Karpuls/E0001-fader-driver-board/docs/review_revC_r1/E0001_revC_bottom.png

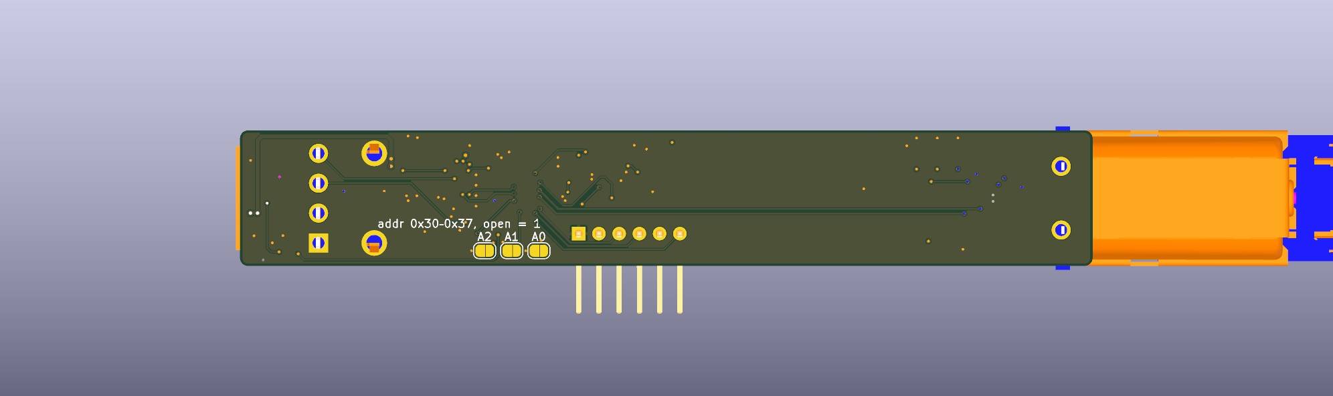
docs/review_revC_r1/E0001_revC_bottom.png
