Karpuls/E0001-fader-driver-board/fab/E0001_revC/PREORDER.md

# E0001 rev C pre-order list (Parts, 2026-10-20)
Items that are low in stock, on a long lead, or not from DigiKey. Quantities are per board.

| Item | Qty/board | Source | Stock / lead | Action |
|---|---|---|---|---|
| CL05A105KP5NNNC (1uF) | 1 | DigiKey 1276-1076-1-ND | 740739 / 61 w | order early (long lead) |
| PESD5V0L1UL,315 (PESD5V0L1UL) | 3 | DigiKey 1727-4193-1-ND | 18740 / 30 w | order early (long lead) |
| BAT54W,135 (BAT54W) | 2 | DigiKey 1727-1869-1-ND | 26776 / 30 w | order early (long lead) |
| SM04B-GHS-TB(LF)(SN) (SM04B-GHS-TB) | 1 | LCSC LCSC C189895 (SM04B-GHS-TB(LF)(SN)) | 1900 (LCSC, 2026-10-19) / 16 w | owner has JST-GH (stock flag); buy only if short |
| STM32C051F6P6 (STM32C051F6P6) | 1 | DigiKey 497-STM32C051F6P6-ND | 47 / 52 w | buy first |

## Notes
- **U1 STM32C051F6P6:** 47 in stock at DigiKey; the approved alternate **STM32C051F8P6** (497-STM32C051F8P6-ND, same pinout, 64 KB) has more stock. Buy whichever is in stock.
- **J1 SM04B-GHS-TB:** owner has JST-GH connectors (flag only; the BOM keeps the line). If more are needed: DigiKey 0 stock; LCSC C189895 (min order 5) or RS Online 1755704 / 7521797.

- **RV1 fader:** owner has the faders (Owner stock = yes); the Amazon.de line (ASIN B0H45B29YK) stays in the BOM at full quantity.
