Karpuls/E0001-fader-driver-board/fab/E0001_revC/reports/E0001_revC_gerber_render.png

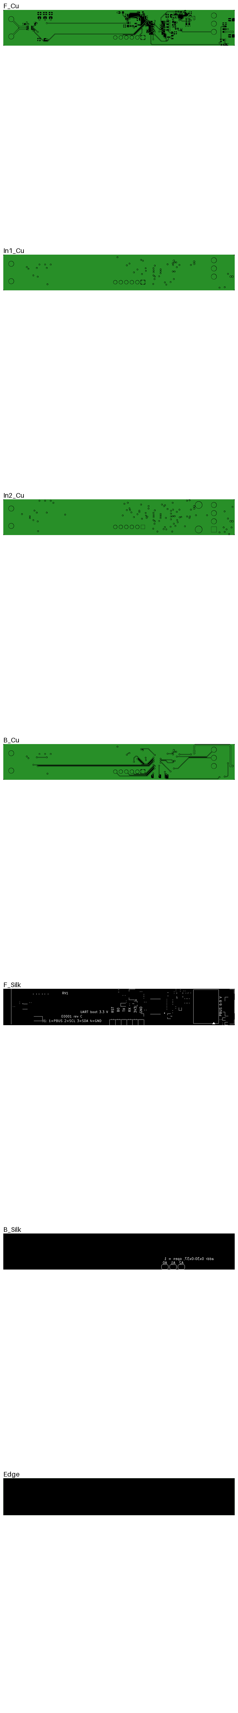
fab/E0001_revC/reports/E0001_revC_gerber_render.png
