Karpuls/E0001-fader-driver-board/bom/E0001_revB_digikey_bom.csv

Quantity | Manufacturer Part Number | Manufacturer | DigiKey Part Number | Value | Package | Designators | Description
1 | CL21A106KPCLQNC | Samsung | 1276-2402-1-ND | 10uF | C_0805_2012Metric | C1 | Unpolarized capacitor, small symbol
2 | GRM188R61E475KE11D | Murata | 490-7203-1-ND | 4.7uF | C_0603_1608Metric | C2 C5 | Unpolarized capacitor, small symbol
1 | CL05A105KP5NNNC | Samsung | 1276-1076-1-ND | 1uF | C_0402_1005Metric | C3 | Unpolarized capacitor, small symbol
6 | CL05B104JO5NNNC | Samsung | 1276-1505-1-ND | 100nF | C_0402_1005Metric | C4 C6 C7 C9 C10 C13 | Unpolarized capacitor, small symbol
2 | CL21A226MOQNNNE | Samsung |  | 22uF | C_0805_2012Metric | C11 C12 | Unpolarized capacitor, small symbol
1 | SMF5.0A | Littelfuse | F5748CT-ND | SMF5V0A | D_SMF | D1 | TVS 5 V standoff, 200 W, on protected +5 V rail
1 | PESD5V0L1UL,315 | Nexperia | 1727-4193-1-ND | PESD5V0L1UL | D_SOD-882 | D2 | Low-capacitance ESD diode on the touch line (knob is user-accessible)
1 | LTST-C191KGKT | Lite-On | 160-1446-1-ND | green | LED_0603_1608Metric | D3 | Light emitting diode, small symbol
1 | AO3401A | Alpha & Omega | 785-1001-1-ND | AO3401A | SOT-23 | Q1 | P-MOSFET, reverse-polarity protection (body diode conducts, channel enhances when VIN is correct)
1 | RC0402FR-0710KL | Yageo | 311-10.0KLRCT-ND | 10k | R_0402_1005Metric | R1 | Resistor, small US symbol
1 | RC0603FR-0710RL | Yageo | 311-10.0HRCT-ND | 10R | R_0603_1608Metric | R2 | Resistor, small US symbol
1 | RK73H1ETTP4701F | KOA Speer | 2019-RK73H1ETTP4701FCT-ND | 4.7k | R_0402_1005Metric | R5 | Resistor, small US symbol
1 | RC0402FR-071ML | Yageo | 311-1.00MLRCT-ND | 1M | R_0402_1005Metric | R6 | Resistor, small US symbol
2 | RC0402FR-071KL | Yageo | 311-1.00KLRCT-ND | 1k | R_0402_1005Metric | R7 R10 | Resistor, small US symbol
2 | RC0402FR-07100KL | Yageo | 311-100KLRCT-ND | 100k | R_0402_1005Metric | R8 R9 | Resistor, small US symbol
1 | STM32C051F6P6 | STMicroelectronics | 497-STM32C051F6P6-ND | STM32C051F6P6 | TSSOP-20_4.4x6.5mm_P0.65mm | U1 | STMicroelectronics Arm Cortex-M0+ MCU, 32KB flash, 12KB RAM, 48 MHz, 2.0-3.6V, TSSOP20 (pinout from ST open pin data STM32C051F6Px.xml)
1 | MCP1703AT-3302E/CB | Microchip | MCP1703AT-3302E/CBCT-ND | MCP1703A-3302E/CB | SOT-23 | U2 | Low Quiescent Current LDO Regulator, 3.3V, 250mA, Vin<=16V, SOT-23
1 | DRV8210PDSGR | Texas Instruments | 296-DRV8210PDSGRCT-ND | DRV8210PDSGR | Texas_DSG0008A_WSON-8-1EP_2x2mm_P0.5mm_EP0.9x1.6mm | U3 | H-Bridge driver, 1.8A, Low Voltage, PWM input, WSON-8
