Karpuls/E0001-fader-driver-board/bom/E0001_revC_bom.csv

Supplier | Qty | QtyBasis | References | Value | Footprint | MPN | Manufacturer | SupplierPN | Stock | Lifecycle | UnitEUR | LeadWeeks | DNP | OwnerStock | Notes
DigiKey | 1 | spec | U1 | STM32C051F6P6 | TSSOP-20 | STM32C051F6P6 | STMicroelectronics | 497-STM32C051F6P6-ND | 47 | Active | 1.28 | 52 |  | no | Approved alternate STM32C051F8P6 (same TSSOP-20 pinout, 64 KB): 497-STM32C051F8P6-ND, stock 1178, EUR 1.34. Buy whichever is in stock.
DigiKey | 1 | spec | U2 | 3.3 V LDO | **SOT-89-3** | MCP1703AT-3302E/MB | Microchip Technology | MCP1703AT-3302E/MBCT-ND | 9366 | Active | 0.66 | 8 |  | no
DigiKey | 1 | spec | U3 | H-bridge | WSON-8 2×2 | DRV8210PDSGR | Texas Instruments | 296-DRV8210PDSGRCT-ND | 3849 | Active | 0.76 | 12 |  | no
DigiKey | 1 | spec | U4 | eFuse | VQFN-HR-10 2×2 (RPW) | TPS259470ARPWR | Texas Instruments | 296-TPS259470ARPWRCT-ND | 78910 | Active | 1.81 | 12 |  | no
LCSC | 1 | spec | J1 | JST-GH 4p | SM04B-GHS-TB horizontal | SM04B-GHS-TB(LF)(SN) | JST Sales America Inc. | LCSC C189895 (SM04B-GHS-TB(LF)(SN)) | 1900 (LCSC, 2026-10-19) | Active | 0.31 USD @5 (LCSC) | 16 |  | yes | DigiKey 455-1566-1-ND stock 0 (16 w). Second sources: RS Online 1755704 / 7521797 (regional stock), LCSC C189895 (min order 5). E0003 uses the same LCSC part.
DigiKey | 1 | spec | J2 | 1×6 2.54 R/A | PinHeader_1x06_P2.54mm_Horizontal | 61300611021 | Würth Elektronik | 732-5339-ND | 6816 | Active | 0.47 | 18 |  | no
Amazon.de | 1 | spec | RV1 | Motor fader 10 k lin | ALPS_RSA0N11M9A0J | RSA0N11M9A0J B10K clone | Fastigeaty (seller Fadianshop) | ASIN B0H45B29YK | not checked (Amazon page blocked) | - |  |  |  | yes | ALPS RSA0N11M9A0J-compatible clone, 100 mm motor fader Owner has the faders (flag only; full quantity stays).
DigiKey | 1 | spec | D1 | SMF9.0A | D_SOD-123F (SMF) | SMF9.0A | Littelfuse Inc. | F5755CT-ND | 2437 | Active | 0.47 | 20 |  | no
DigiKey | 3 | spec | D2 D4 D5 | ESD | D_SOD-882 | PESD5V0L1UL,315 | Nexperia USA Inc. | 1727-4193-1-ND | 18740 | Active | 0.22 | 30 |  | no
DigiKey | 1 | spec | D3 | LED green | 0603 | LTST-C191KGKT | Lite-On Inc. | 160-1446-1-ND | 2812317 | Active | 0.13 | 14 |  | no
DigiKey | 2 | spec | D6 D7 | Schottky | SOT-323 | BAT54W,135 | Nexperia USA Inc. | 1727-1869-1-ND | 26776 | Active | 0.17 | 30 |  | no
DigiKey | 4 | spec | C1 C11 C12 C20 | 10 µF 25 V X5R | 0805 | TMK212BBJ106MG-T | Taiyo Yuden | 587-6025-1-ND | 237658 | Active | 0.18 | 23 |  | no
DigiKey | 3 | spec | C2 C5 C18 | 4.7 µF 25 V | 0603 | GRM188R61E475KE11D | Murata Electronics | 490-7203-1-ND | 713624 | Active | 0.21 | 17 |  | no
DigiKey | 1 | spec | C3 | 1 µF 10 V | 0402 | CL05A105KP5NNNC | Samsung Electro-Mechanics | 1276-1076-1-ND | 911254 | Active | 0.09 | 61 |  | no
DigiKey | 7 | spec | C4 C6 C7 C9 C10 C13 C17 | 100 nF 50 V X7R | 0402 | GRM155R71H104KE14D | Murata Electronics | 490-10700-1-ND | 1430736 | Active | 0.09 | 17 |  | no
DigiKey | 1 | spec | C14 | 10 nF 50 V | 0402 | GRM155R71H103KA88D | Murata Electronics | 490-4516-1-ND | 4127456 | Active | 0.09 | 17 | DNP | no
DigiKey | 1 | spec | C15 | 4.7 nF 50 V (ITIMER) | 0402 | GRM155R71H472KA01J | Murata Electronics | 490-8259-1-ND | 143253 | Active | 0.09 | 17 |  | no
DigiKey | 1 | spec | C16 | 1.8 nF 50 V (dVdt) | 0402 | C0402C182K5RACTU | KEMET | 399-C0402C182K5RACTUCT-ND | 9731 | Active | 0.44 | 17 |  | no
DigiKey | 1 | spec | C19 | 1 nF 50 V (ILM ADC) | 0402 | GRM155R71H102KA01D | Murata Electronics | 490-1303-1-ND | 4189153 | Active | 0.1 | 21 |  | no
DigiKey | 1 | spec | R2 | 10 Ω | 0603 | RC0603FR-0710RL | YAGEO | 311-10.0HRCT-ND | 264276 | Active | 0.1 | 22 |  | no
DigiKey | 1 | spec | R5 | 4.7 kΩ | 0402 | RK73H1ETTP4701F | KOA Speer Electronics, Inc. | 2019-RK73H1ETTP4701FCT-ND | 2889565 | Active | 0.09 | 7 |  | no
DigiKey | 3 | spec | R6 R11 R13 | 1 MΩ 1 % | 0402 | RC0402FR-071ML | YAGEO | 311-1.00MLRCT-ND | 961162 | Active | 0.09 | 22 |  | no
DigiKey | 3 | spec | R7 R10 R18 | 1 kΩ | 0402 | RC0402FR-071KL | YAGEO | 311-1.00KLRCT-ND | 3584811 | Active | 0.09 | 22 |  | no
DigiKey | 1 | spec | R8 | 100 kΩ | 0402 | RC0402FR-07100KL | YAGEO | 311-100KLRCT-ND | 6147223 | Active | 0.09 | 22 |  | no
DigiKey | 1 | spec | R9 | 30.1 kΩ 1 % | 0402 | RC0402FR-0730K1L | YAGEO | 311-30.1KLRCT-ND | 12740 | Active | 0.09 | 22 |  | no
DigiKey | 1 | spec | R12 | 330 kΩ 1 % | 0402 | RC0402FR-07330KL | YAGEO | 311-330KLRCT-ND | 902151 | Active | 0.09 | 22 |  | no
DigiKey | 1 | spec | R14 | 137 kΩ 1 % | 0402 | RC0402FR-07137KL | YAGEO | YAG2972CT-ND | 126860 | Active | 0.09 | 22 |  | no
DigiKey | 1 | spec | R15 | 5.23 kΩ 1 % | 0402 | RC0402FR-075K23L | YAGEO | YAG3195CT-ND | 39950 | Active | 0.09 | 22 |  | no
DigiKey | 2 | spec | R16 R17 | 10 kΩ | 0402 | RC0402FR-0710KL | YAGEO | 311-10.0KLRCT-ND | 10874291 | Active | 0.09 | 22 |  | no
DigiKey | 2 | spec | R19 R20 | 0 Ω | 0402 | RC0402JR-070RL | YAGEO | 311-0.0JRCT-ND | 1032165 | Active | 0.09 | 22 |  | no
PCB | 3 | spec | JP1 JP2 JP3 | solder jumper | SolderJumper-2 open | — | - | - | - | - | 0 |  |  | no | Open solder jumper (PCB feature, no part)
