Karpuls/E0001-fader-driver-board/mech/fader_board_assembly.step

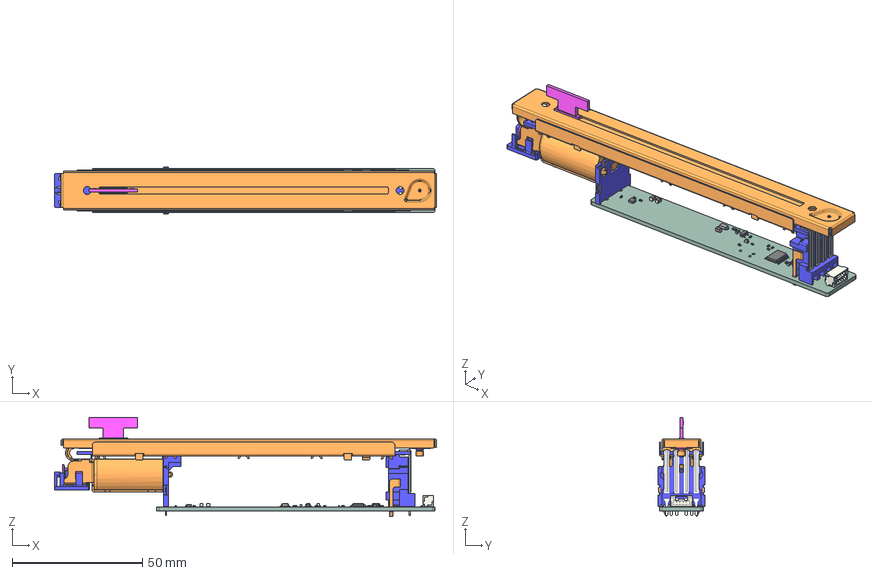
[picture p5: CAD file, 2026-10-07]
mech/fader_board_assembly.step
146.6 x 18.0 x 38.0 mm
R_0402_1005Metric x 7
JST_SM04B_GHS_TB
C_0402_1005Metric x 8
C_0603_1608Metric x 2
TSSOP-20_4.4x6.5mm_P0.65mm
LED_0603_1608Metric
C_0805_2012Metric x 3
SOT-23 x 2
R_0603_1608Metric
D_SMF
D_SOD-882
WSON_8_1EP_2x2mm_P05mm_EP09x16mm
E0001_fader_driver_PCB
