Karpuls/E0001-fader-driver-board/fab/E0001_revC/3d/E0001_revC.step

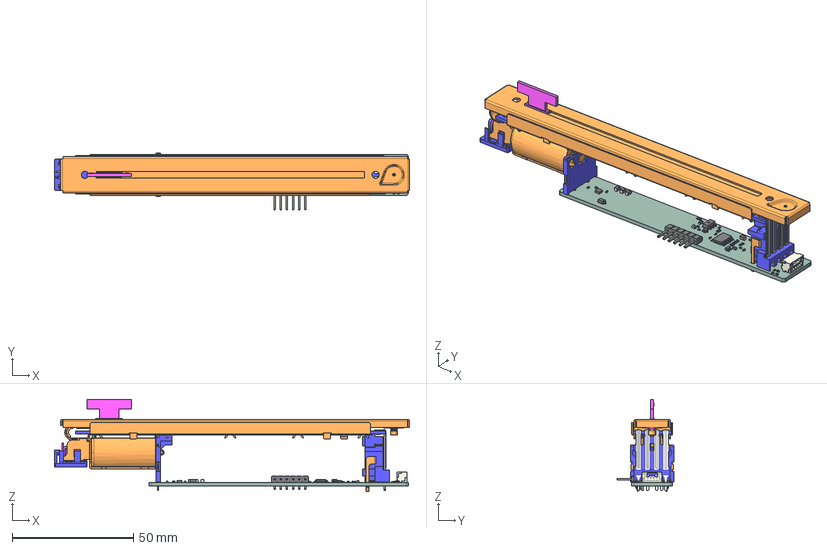
[picture p6: CAD file, 2026-10-20]
fab/E0001_revC/3d/E0001_revC.step
146.6 x 23.5 x 38.0 mm
C_0805_2012Metric x 4
R_0402_1005Metric x 16
C_0402_1005Metric x 12
JST_SM04B_GHS_TB
TSSOP-20_4.4x6.5mm_P0.65mm
SOT-323_SC-70 x 2
D_SOD-882 x 3
C_0603_1608Metric x 3
adbeea57-9c39-11ed-93f0-dde97e994e83_part
adbeea58-9c39-11ed-93f0-dde97e994e83_part
adbeea59-9c39-11ed-93f0-dde97e994e83_part
PinHeader_1x06_P254mm_Horizontal
D_SOD_123F
R_0603_1608Metric
LED_0603_1608Metric
WSON_8_1EP_2x2mm_P05mm_EP09x16mm
E0001_fader_driver_PCB
