Karpuls/E0001-fader-driver-board/archive/revA/fader_board_assembly.step

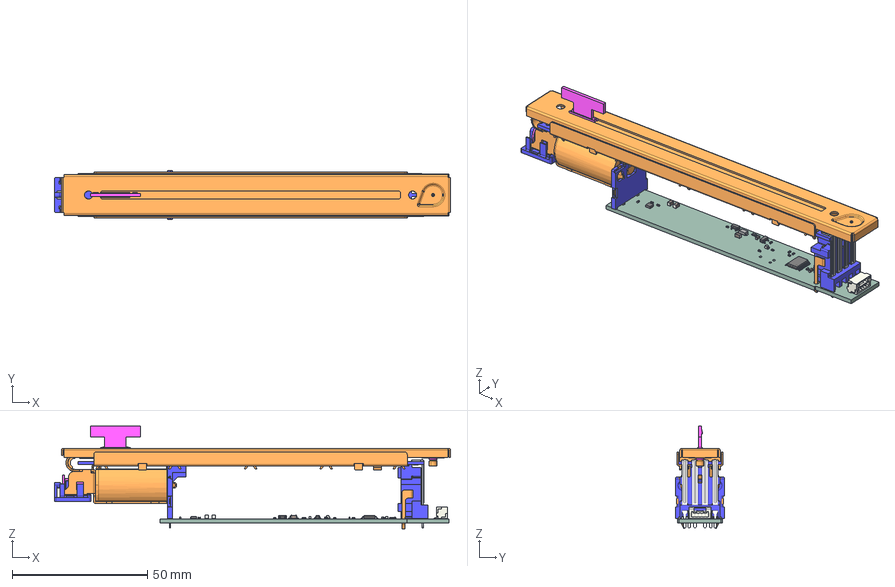
[picture p7: CAD file, 2026-10-07, an earlier design]
archive/revA/fader_board_assembly.step
146.6 x 18.0 x 38.0 mm
LED_0603_1608Metric
R_0603_1608Metric
SOT-23 x 2
R_0402_1005Metric x 7
C_0402_1005Metric x 8
C_0805_2012Metric x 3
C_0603_1608Metric x 2
JST_SM04B_GHS_TB
D_SMF
WSON_8_1EP_2x2mm_P05mm_EP09x16mm
TSSOP-20_4.4x6.5mm_P0.65mm
D_SOD-882
E0001_fader_driver_PCB
