Karpuls/E0001-fader-driver-board/(list of files, cad)

Other CAD files:
fab/E0001_revB/3d/E0001_revB.step
