Karpuls/E0001-fader-driver-board/mech/renders/fader_board_assembly.iso.png

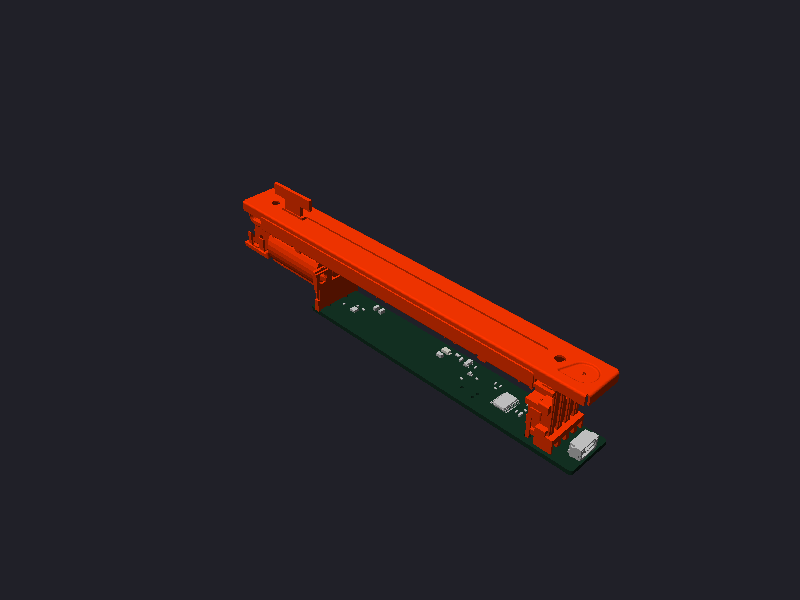
mech/renders/fader_board_assembly.iso.png
