Karpuls/E0001-fader-driver-board/mech/renders/fader_board_assembly.right.png

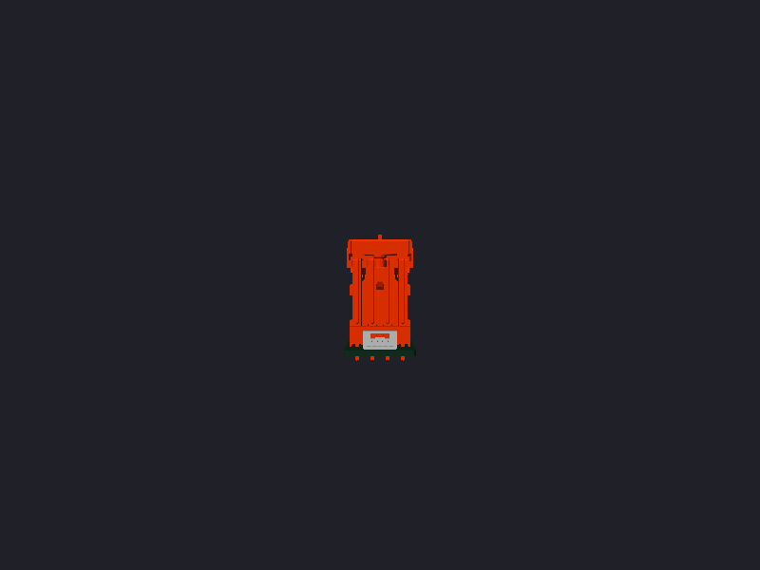
mech/renders/fader_board_assembly.right.png
