Karpuls/E0001-fader-driver-board/fab/E0001_revC/assembly/E0001_revC_assembly_bottom.pdf

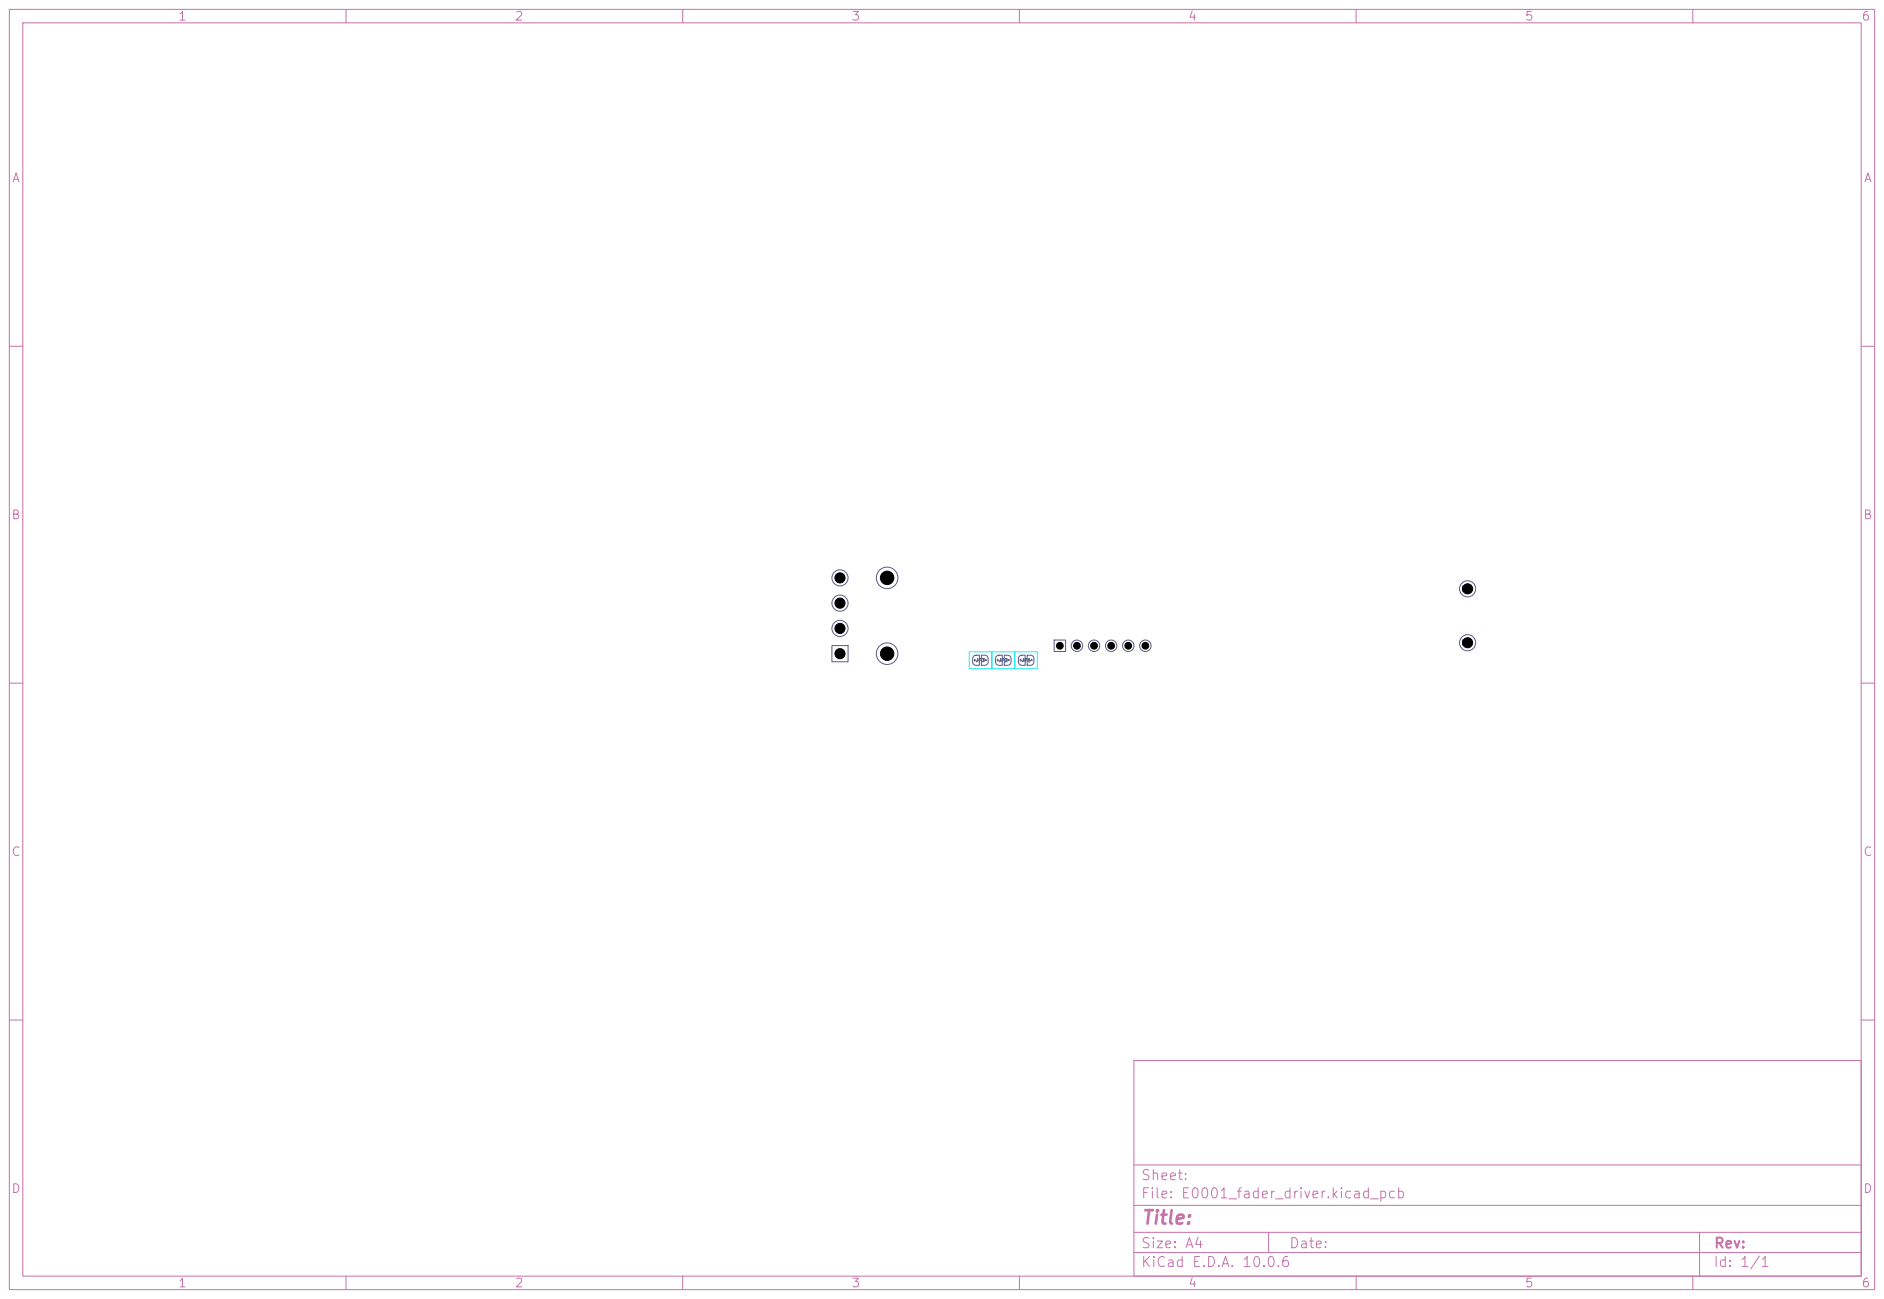
[picture p12: page 1]

Size: A4 | Rev:
KiCad E.D.A. 10.0.6 | Id: 1/1
