Karpuls/E0001-fader-driver-board/fab/E0001_revB/assembly/E0001_revB_assembly_top.pdf

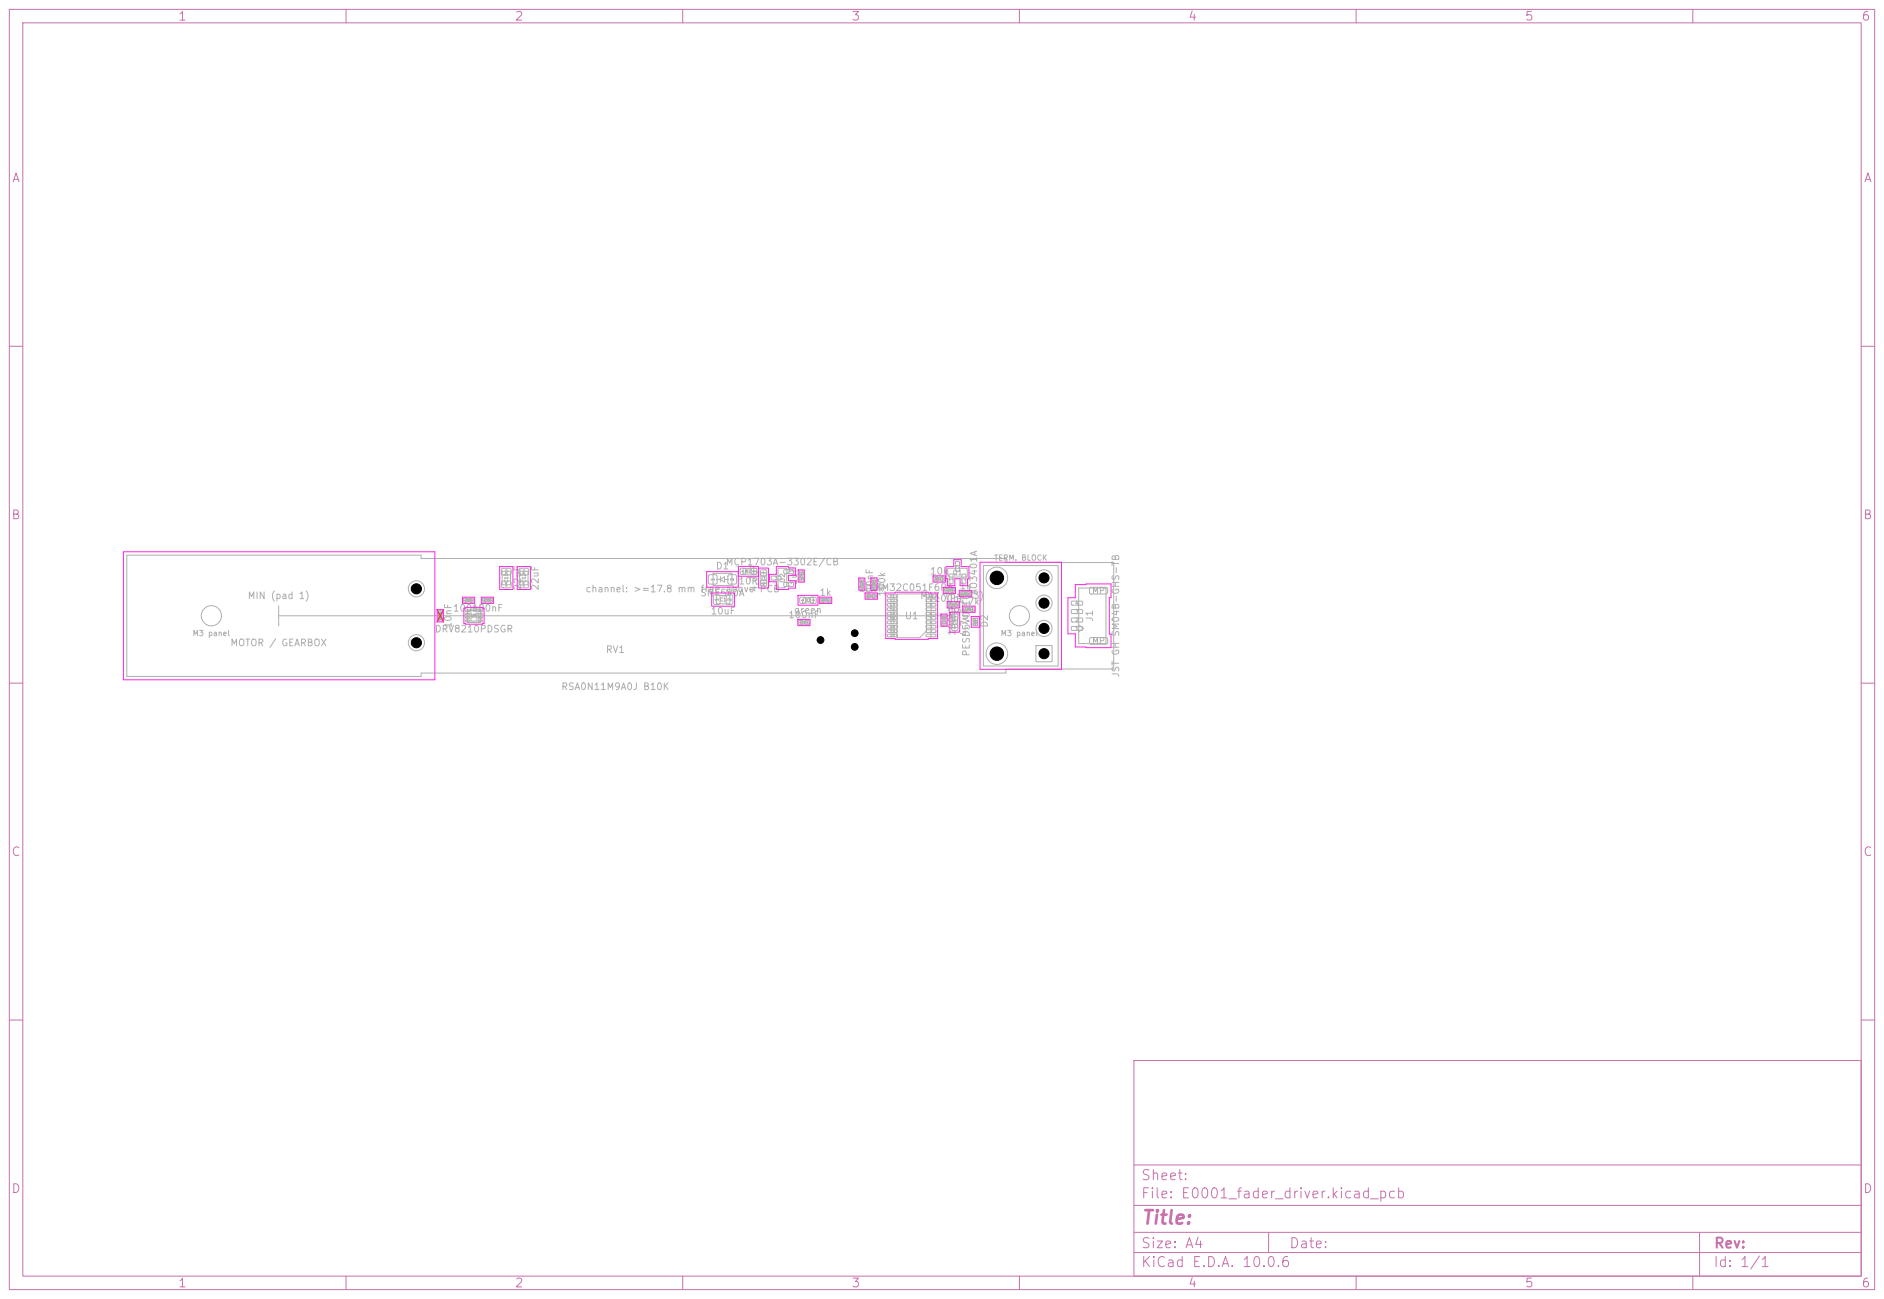
[picture p16: page 1]

Size: A4 | Rev:
KiCad E.D.A. 10.0.6 | Id: 1/1
