Karpuls/E0001-fader-driver-board/fab/E0001_revB/docs/E0001_revB_schematic.pdf

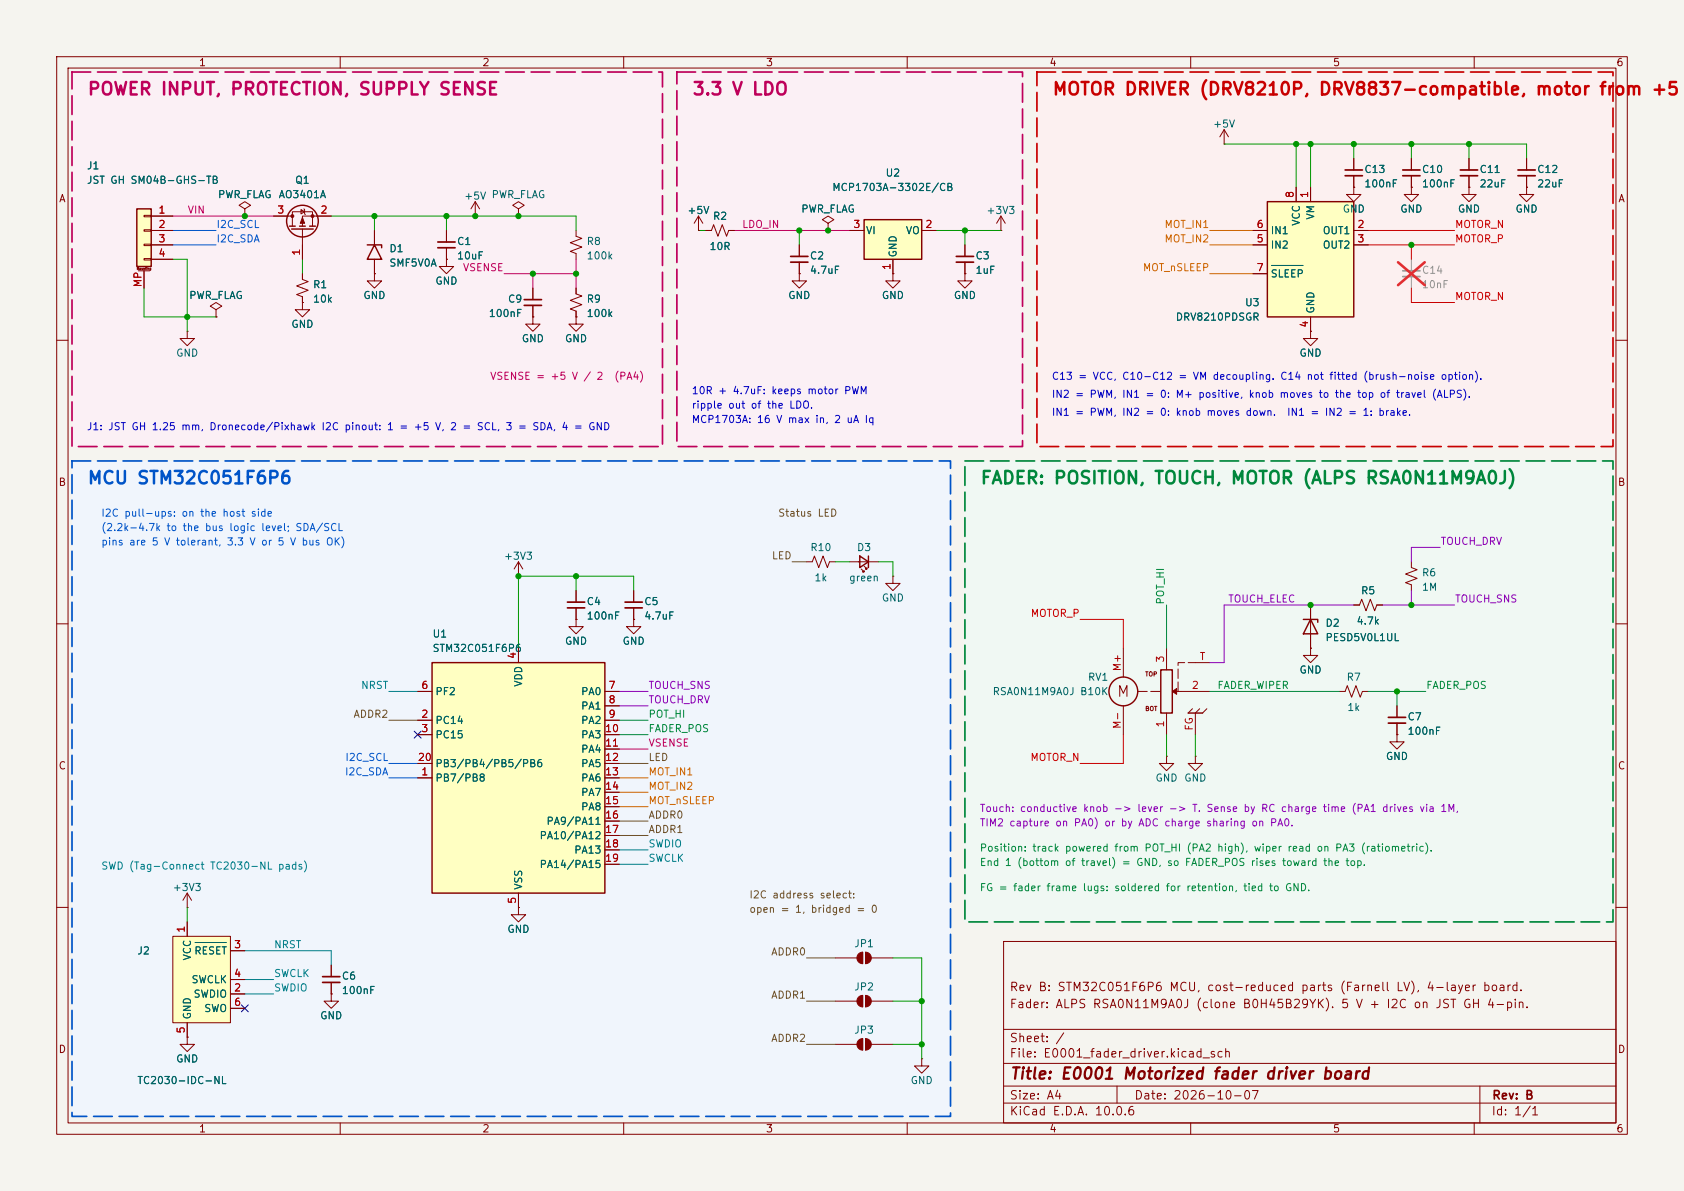
[picture p17: page 1]

POWER INPUT, PROTECTION, SUPPLY SENSE

MOTOR DRIVER (DRV8210P, DRV8837-compatible, motor from +5 V)

JST GH SM04B-GHS-TB

C13 = VCC, C10-C12 = VM decoupling. C14 not fitted (brush-noise option).
IN2 = PWM, IN1 = 0: M+ positive, knob moves to the top of travel (ALPS).
IN1 = PWM, IN2 = 0: knob moves down. IN1 = IN2 = 1: brake.

ripple out of the LDO. 10R + 4.7uF: keeps motor PWM MCU STM32C051F6P6

J1: JST GH 1.25 mm, Dronecode/Pixhawk I2C pinout: 1 = +5 V, 2 = SCL, 3 = SDA, 4 = GND

FADER: POSITION, TOUCH, MOTOR (ALPS RSA0N11M9A0J)
JP2 GND

I2C pull-ups: on the host side

pins are 5 V tolerant, 3.3 V or 5 V bus OK)

Touch: conductive knob -> lever -> T. Sense by RC charge time (PA1 drives via 1M,
TIM2 capture on PA0) or by ADC charge sharing on PA0. Position: track powered from POT_HI (PA2 high), wiper read on PA3 (ratiometric). End 1 (bottom of travel) = GND, so FADER_POS rises toward the top. FG = fader frame lugs: soldered for retention, tied to GND.

SWD (Tag-Connect TC2030-NL pads)

I2C address select: open = 1, bridged = 0

Rev B: STM32C051F6P6 MCU, cost-reduced parts (Farnell LV), 4-layer board.
Fader: ALPS RSA0N11M9A0J (clone B0H45B29YK). 5 V + I2C on JST GH 4-pin.

Sheet: /
File: E0001_fader_driver.kicad_sch
Title: E0001 Motorized fader driver board

Size: A4 | Rev: B
KiCad E.D.A. 10.0.6 | Id: 1/1
