Karpuls/E0001-fader-driver-board/(list of files, drawings)

Other design files:
build/hr/fr/fr.dsn
