Karpuls/E0001-fader-driver-board/E0001_fader_driver.kicad_pcb

## KiCad design E0001_fader_driver.kicad_pcb (2026-10-23)

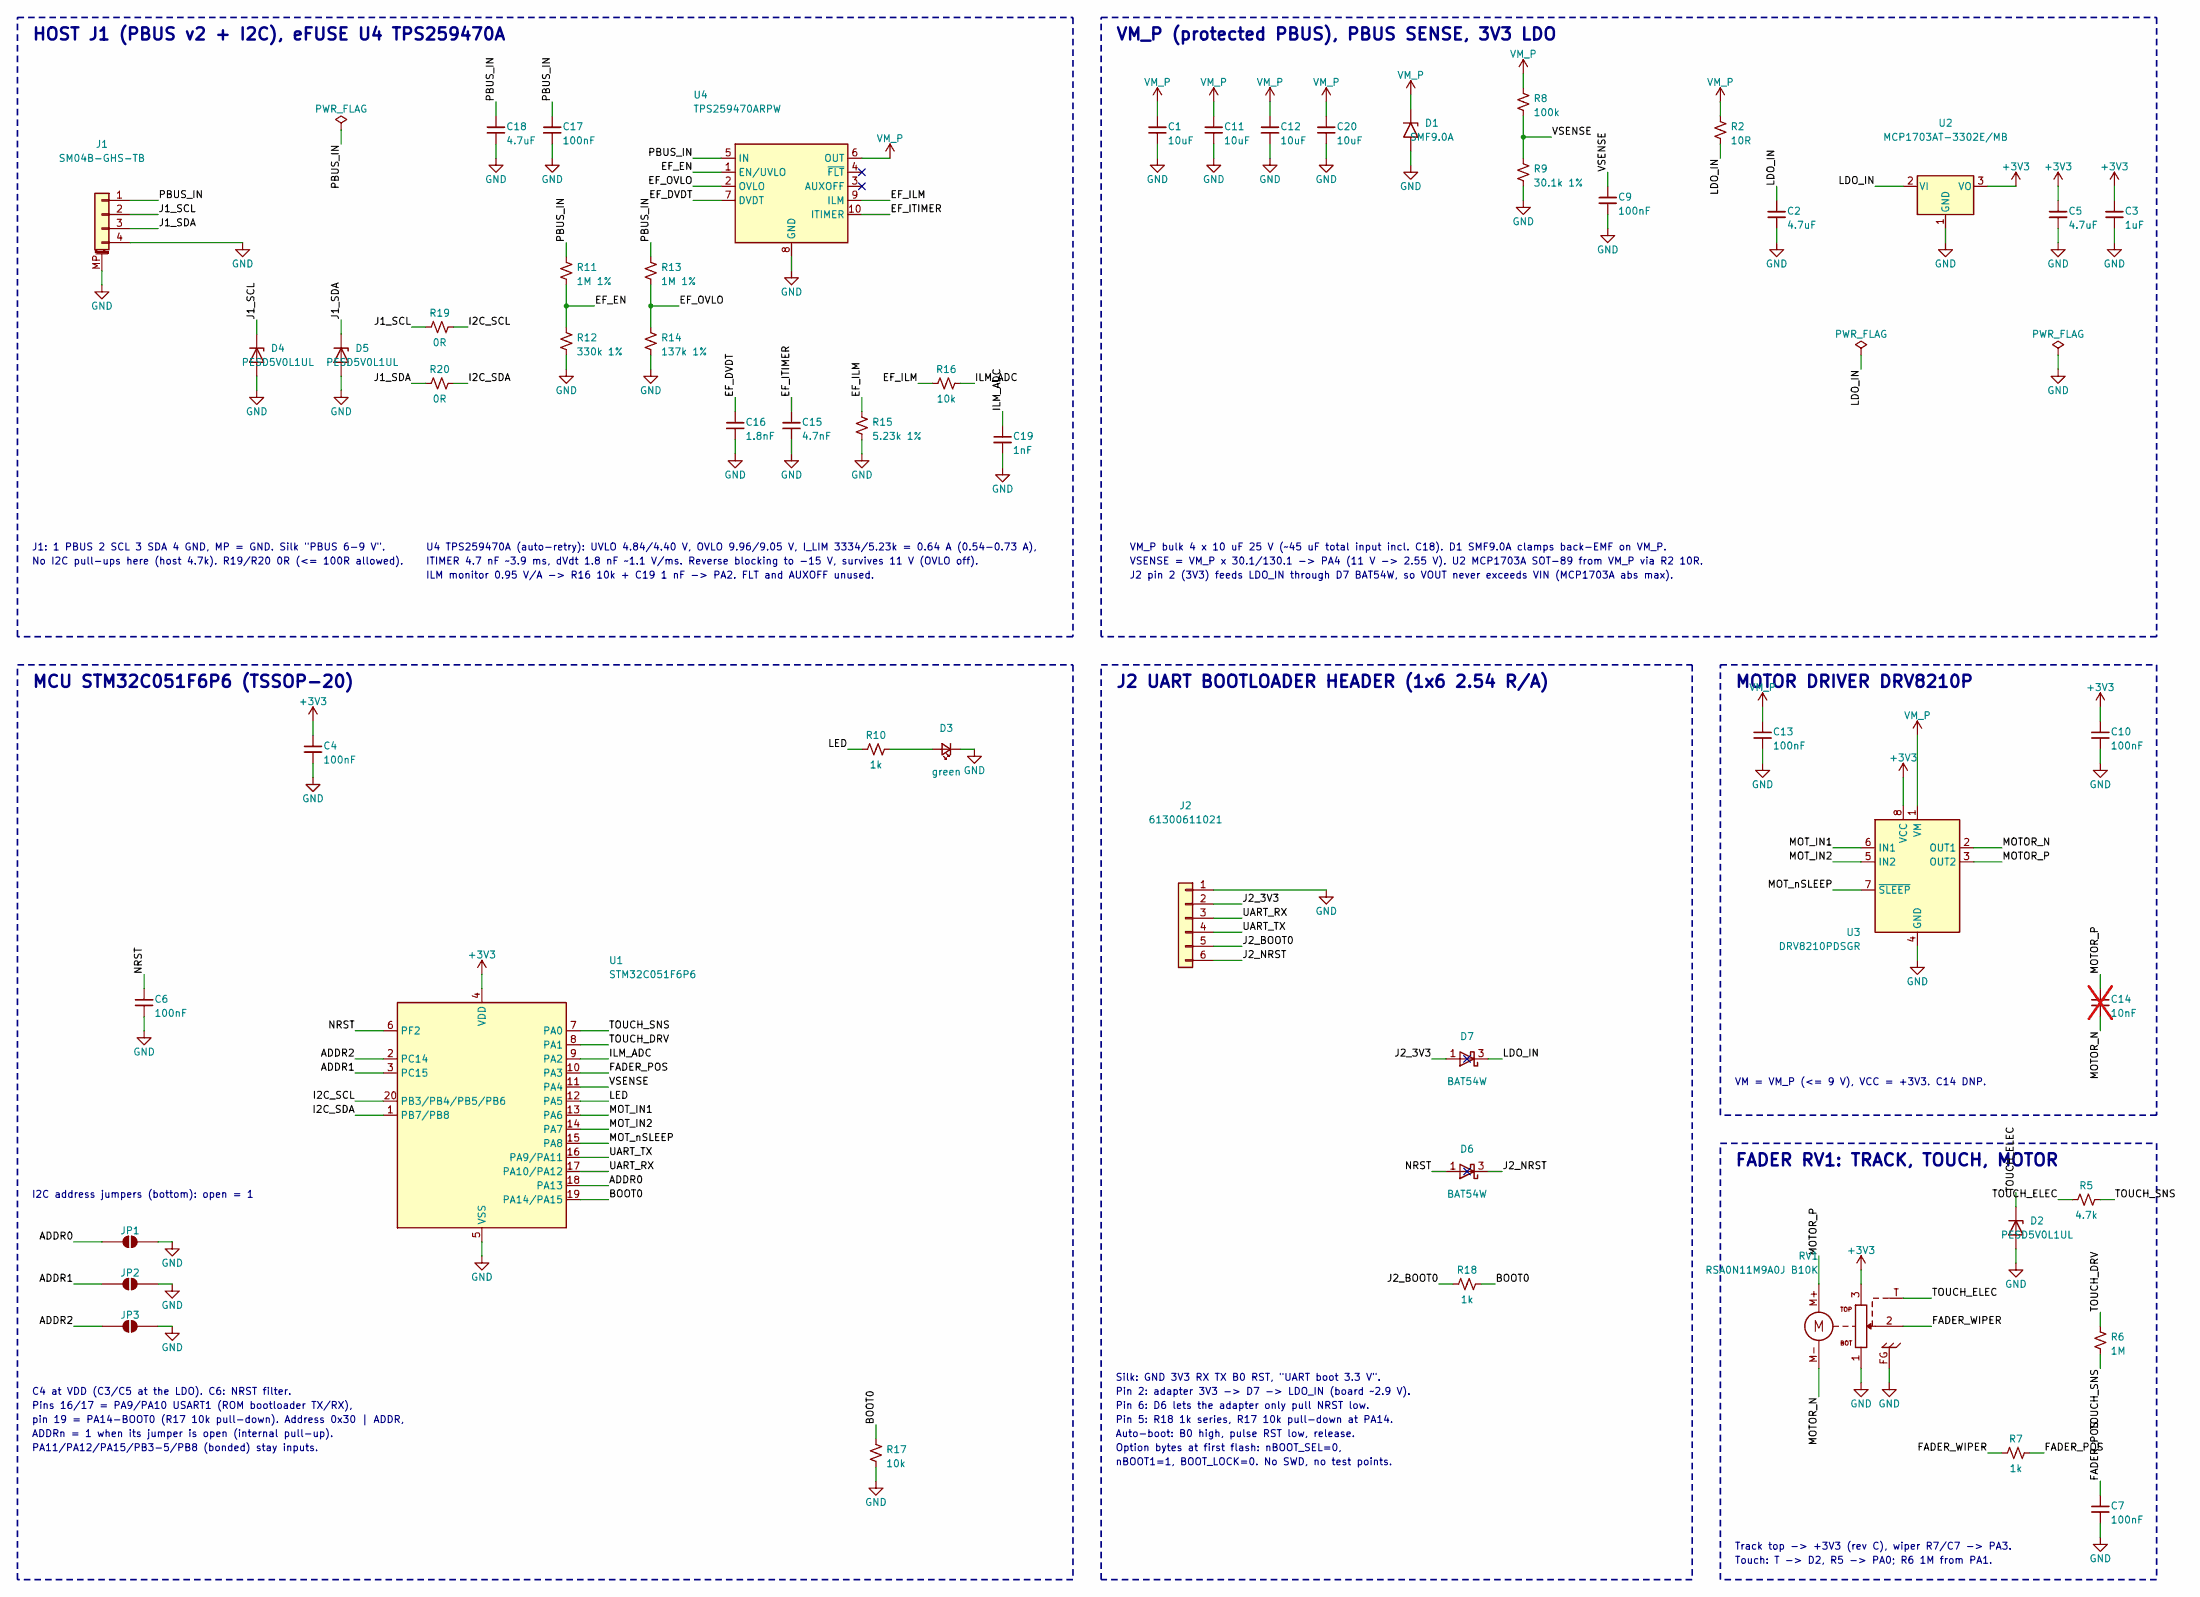
[picture p18: schematic E0001_fader_driver.kicad_sch, E0001 Motorized fader driver board]

Parts:
C1, C11, C12, C20: 10uF; C_0805_2012Metric; Voltage 25V; MPN TMK212BBJ106MG-T
C2, C5, C18: 4.7uF; C_0603_1608Metric; Voltage 25V; MPN GRM188R61E475KE11D
C3: 1uF; C_0402_1005Metric; MPN CL05A105KP5NNNC
C4, C6, C7, C9, C10, C13, C17: 100nF; C_0402_1005Metric; Voltage 50V; MPN GRM155R71H104KE14D
C14: 10nF; C_0402_1005Metric; Voltage 50V; MPN GRM155R71H103KA88D; not fitted
C15: 4.7nF; C_0402_1005Metric; Voltage 50V; MPN GRM155R71H472KA01J
C16: 1.8nF; C_0402_1005Metric; Voltage 50V; MPN C0402C182K5RACTU
C19: 1nF; C_0402_1005Metric; Voltage 50V; MPN GRM155R71H102KA01D
D1: SMF9.0A; D_SOD-123F; MPN SMF9.0A
D2, D4, D5: PESD5V0L1UL; D_SOD-882; MPN PESD5V0L1UL,315
D3: green; LED_0603_1608Metric; MPN LTST-C191KGKT
D6, D7: BAT54W; SOT-323_SC-70; MPN BAT54W,135
J1: SM04B-GHS-TB; JST_GH_SM04B-GHS-TB_1x04-1MP_P1.25mm_Horizontal; MPN SM04B-GHS-TB(LF)(SN)
J2: 61300611021; PinHeader_1x06_P2.54mm_Horizontal; MPN 61300611021
JP1: ADDR0; SolderJumper-2_P1.3mm_Open_RoundedPad1.0x1.5mm
JP2: ADDR1; SolderJumper-2_P1.3mm_Open_RoundedPad1.0x1.5mm
JP3: ADDR2; SolderJumper-2_P1.3mm_Open_RoundedPad1.0x1.5mm
R2: 10R; R_0603_1608Metric; MPN RC0603FR-0710RL
R5: 4.7k; R_0402_1005Metric; MPN RK73H1ETTP4701F
R6: 1M; R_0402_1005Metric; MPN RC0402FR-071ML
R7, R10, R18: 1k; R_0402_1005Metric; MPN RC0402FR-071KL
R8: 100k; R_0402_1005Metric; MPN RC0402FR-07100KL
R9: 30.1k 1%; R_0402_1005Metric; MPN RC0402FR-0730K1L
R11, R13: 1M 1%; R_0402_1005Metric; MPN RC0402FR-071ML
R12: 330k 1%; R_0402_1005Metric; MPN RC0402FR-07330KL
R14: 137k 1%; R_0402_1005Metric; MPN RC0402FR-07137KL
R15: 5.23k 1%; R_0402_1005Metric; MPN RC0402FR-075K23L
R16, R17: 10k; R_0402_1005Metric; MPN RC0402FR-0710KL
R19, R20: 0R; R_0402_1005Metric; MPN RC0402JR-070RL
RV1: RSA0N11M9A0J B10K; ALPS_RSA0N11M9A0J; MPN RSA0N11M9A0J B10K clone
U1: STM32C051F6P6; TSSOP-20_4.4x6.5mm_P0.65mm; MPN STM32C051F6P6
U2: MCP1703AT-3302E/MB; SOT-89-3; MPN MCP1703AT-3302E/MB
U3: DRV8210PDSGR; Texas_DSG0008A_WSON-8-1EP_2x2mm_P0.5mm_EP0.9x1.6mm; MPN DRV8210PDSGR
U4: TPS259470ARPW; TI_RPW0010A_VQFN-HR-10_2x2mm_P0.475mm; MPN TPS259470ARPWR

Connections:
+3V3: C3.1, C4.1, C5.1, C10.1, RV1.3 (END_TOP), U1.4 (VDD), U2.3 (VO), U3.8 (VCC)
/ADDR0: JP1.1 (A), U1.18 (PA13)
/ADDR1: JP2.1 (A), U1.3 (PC15)
/ADDR2: JP3.1 (A), U1.2 (PC14)
/BOOT0: R17.1, R18.2, U1.19 (PA14/PA15)
/EF_DVDT: C16.1, U4.7 (DVDT)
/EF_EN: R11.2, R12.1, U4.1 (EN/UVLO)
/EF_ILM: R15.1, R16.1, U4.9 (ILM)
/EF_ITIMER: C15.1, U4.10 (ITIMER)
/EF_OVLO: R13.2, R14.1, U4.2 (OVLO)
/FADER_POS: C7.1, R7.2, U1.10 (PA3)
/FADER_WIPER: R7.1, RV1.2 (WIPER)
/I2C_SCL: R19.2, U1.20 (PB3/PB4/PB5/PB6)
/I2C_SDA: R20.2, U1.1 (PB7/PB8)
/ILM_ADC: C19.1, R16.2, U1.9 (PA2)
/J1_SCL: D4.1 (K), J1.2, R19.1
/J1_SDA: D5.1 (K), J1.3, R20.1
/J2_3V3: D7.1 (A), J2.2
/J2_BOOT0: J2.5, R18.1
/J2_NRST: D6.3 (K), J2.6
/LDO_IN: C2.1, D7.3 (K), R2.2, U2.2 (VI)
/LED: R10.1, U1.12 (PA5)
/MOTOR_N: C14.2, RV1.M-, U3.2 (OUT1)
/MOTOR_P: C14.1, RV1.M+, U3.3 (OUT2)
/MOT_IN1: U1.13 (PA6), U3.6 (IN1)
/MOT_IN2: U1.14 (PA7), U3.5 (IN2)
/MOT_nSLEEP: U1.15 (PA8), U3.7 (~SLEEP)
/NRST: C6.1, D6.1 (A), U1.6 (PF2)
/PBUS_IN: C17.1, C18.1, J1.1, R11.1, R13.1, U4.5 (IN)
/TOUCH_DRV: R6.1, U1.8 (PA1)
/TOUCH_ELEC: D2.1 (K), R5.1, RV1.T (TOUCH)
/TOUCH_SNS: R5.2, R6.2, U1.7 (PA0)
/UART_RX: J2.3, U1.17 (PA10/PA12)
/UART_TX: J2.4, U1.16 (PA9/PA11)
/VSENSE: C9.1, R8.2, R9.1, U1.11 (PA4)
GND: C1.2, C2.2, C3.2, C4.2, C5.2, C6.2, C7.2, C9.2, C10.2, C11.2, C12.2, C13.2, C15.2, C16.2, C17.2, C18.2, C19.2, C20.2, D1.2 (A2), D2.2 (A), D3.1 (K), D4.2 (A), D5.2 (A), J1.4, J1.MP (MountPin), J2.1, JP1.2 (B), JP2.2 (B), JP3.2 (B), R9.2, R12.2, R14.2, R15.2, R17.2, RV1.1 (END_BOT), RV1.FG (FRAME), U1.5 (VSS), U2.1 (GND), U3.4 (GND), U3.9 (GND), U4.8 (GND)
unnamed: D3.2 (A), R10.2
VM_P: C1.1, C11.1, C12.1, C13.1, C20.1, D1.1 (A1), R2.1, R8.1, U3.1 (VM), U4.6 (OUT)

Notes on the sheet:
HOST J1 (PBUS v2 + I2C), eFUSE U4 TPS259470A
J1: 1 PBUS 2 SCL 3 SDA 4 GND, MP = GND. Silk "PBUS 6-9 V".
No I2C pull-ups here (host 4.7k). R19/R20 0R (<= 100R allowed).
U4 TPS259470A (auto-retry): UVLO 4.84/4.40 V, OVLO 9.96/9.05 V, I_LIM 3334/5.23k = 0.64 A (0.54-0.73 A),
ITIMER 4.7 nF ~3.9 ms, dVdt 1.8 nF ~1.1 V/ms. Reverse blocking to -15 V, survives 11 V (OVLO off).
ILM monitor 0.95 V/A -> R16 10k + C19 1 nF -> PA2. FLT and AUXOFF unused.
VM_P (protected PBUS), PBUS SENSE, 3V3 LDO
VM_P bulk 4 x 10 uF 25 V (~45 uF total input incl. C18). D1 SMF9.0A clamps back-EMF on VM_P.
VSENSE = VM_P x 30.1/130.1 -> PA4 (11 V -> 2.55 V). U2 MCP1703A SOT-89 from VM_P via R2 10R.
J2 pin 2 (3V3) feeds LDO_IN through D7 BAT54W, so VOUT never exceeds VIN (MCP1703A abs max).
MCU STM32C051F6P6 (TSSOP-20)
C4 at VDD (C3/C5 at the LDO). C6: NRST filter.
Pins 16/17 = PA9/PA10 USART1 (ROM bootloader TX/RX),
pin 19 = PA14-BOOT0 (R17 10k pull-down). Address 0x30 | ADDR,
ADDRn = 1 when its jumper is open (internal pull-up).
PA11/PA12/PA15/PB3-5/PB8 (bonded) stay inputs.
I2C address jumpers (bottom): open = 1
J2 UART BOOTLOADER HEADER (1x6 2.54 R/A)
Silk: GND 3V3 RX TX B0 RST, "UART boot 3.3 V".
Pin 2: adapter 3V3 -> D7 -> LDO_IN (board ~2.9 V).
Pin 6: D6 lets the adapter only pull NRST low.
Pin 5: R18 1k series, R17 10k pull-down at PA14.
Auto-boot: B0 high, pulse RST low, release.
Option bytes at first flash: nBOOT_SEL=0,
nBOOT1=1, BOOT_LOCK=0. No SWD, no test points.
MOTOR DRIVER DRV8210P
VM = VM_P (<= 9 V), VCC = +3V3. C14 DNP.
FADER RV1: TRACK, TOUCH, MOTOR
Track top -> +3V3 (rev C), wiper R7/C7 -> PA3.
Touch: T -> D2, R5 -> PA0; R6 1M from PA1.

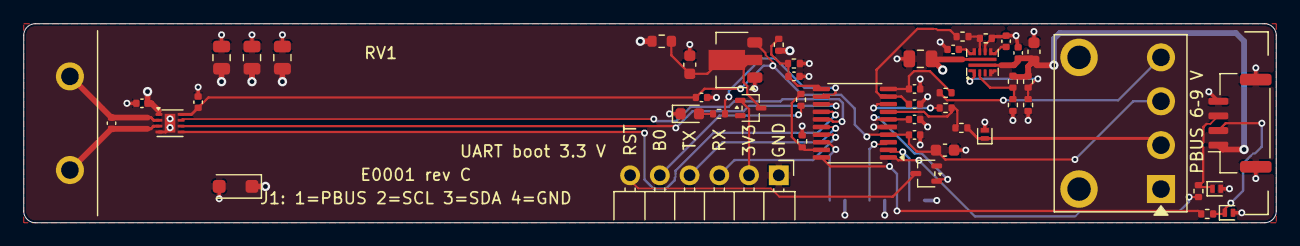
[picture p19: board E0001_fader_driver.kicad_pcb from above]

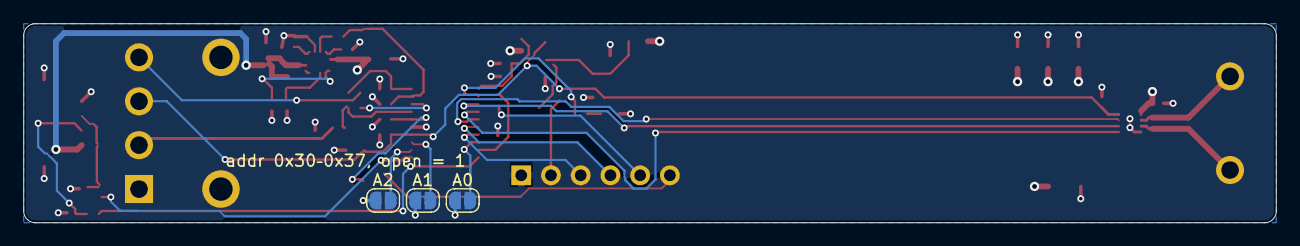
[picture p20: board E0001_fader_driver.kicad_pcb from below]

Board: 4 copper layers, 107.0 x 17.0 mm, 53 parts (3 on the bottom side), 38 nets.
