Karpuls/E0001-fader-driver-board/(commit log)

2026-10-07 Initial project version
    [E0001_fader_driver.kicad_pcb, E0001_fader_driver.kicad_sch, E0001_revB_digikey_bom.csv, board.dsn, fader_board_assembly.step, pads.tsv, prerouted_backup.kicad_pcb]
2026-10-07 Design motorized fader control board
2026-10-07 E0001 motorized fader driver board, rev B
    KiCad 10 project for an ALPS RSA0N11M9A0J-compatible motorized fader:
    STM32C051F6P6, DRV8210P, MCP1703A, touch sense, JST GH I2C/5V,
    4-layer 107x17 mm board. Rev A archived in archive/revA.
2026-10-07 Stop tracking generated build outputs
    [board.dsn, pads.tsv, prerouted_backup.kicad_pcb]
2026-10-07 Apply rev B layout/routing QC fixes
    - ADDR0/ADDR1: via under U1, direct B.Cu runs to JP1/JP2 (detour 4.3x -> 1.3x);
    NRST B.Cu moved above the ADDR vias; SWCLK hairpin around J2 removed
    - MOT_nSLEEP runs alongside IN1/IN2 (70.8 -> 63.0 mm), B.Cu crossover at U3
    - Uniform 0.2 mm signal widths, 0.3 mm +3V3 trunk, tidied +5V widths
    - Removed 15 snapping stubs, 5 acute corners and all off-45 deg segments
    - 6 GND stitching vias near U3 and along the motor-control bundle
    - Silkscreen to JLC minimums (1.0 mm / 0.15 mm); RV1 silk pulled inside
    the board edge (board and Fader library updated together)
    - Add JLCPCB 4-layer .kicad_dru; DRC: 0 errors/warnings, 0 unconnected,
    0 parity issues
    Co-Aut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
    [E0001_fader_driver.kicad_pcb]
2026-10-07 Layout QC round 2: acid traps, I2C reroute around fader touch pad
    - +3V3 trunk runs through C3 pad 1 centre; NRST C6 branch and VSENSE R8
    feed now join at 90 deg instead of 45 deg wedges
    - I2C: straight parallel SCL/SDA pair from U1 (no jog around FG, no hook
    at pin 20), dropping between FG and RV1 pad 1 and rising into J1 at
    x 166.8/167.25; edge gap to touch pad T 0.28 -> 1.85 mm, GND pour now
    fills around pad T. ADDR2 via moved under the U1 body to make room
    - Chamfered right angles on +3V3, VIN, +5V, LDO_IN and TOUCH_ELEC;
    SWDIO aligned to U1 pin 18
    - DRC (JLC rules): 0 violations, 0 unconnected, 0 parity issues
    [E0001_fader_driver.kicad_pcb]
2026-10-20 E0001 rev C: PBUS v2 input, local eFuse, UART bootloader header, fab outputs
    - Supply from E0003 peripheral bus v2 (PBUS 6-9 V) instead of 5 V
    - TPS259470A local eFuse (OVLO, 0.6 A limit, reverse blocking); SMF9.0A after eFuse
    - MCP1703A SOT-89 LDO; DRV8210 logic on 3V3
    - Tag-Connect SWD replaced by 1x6 right-angle UART bootloader header (J2)
    - No test points; common cross-project parts; PBUS 6-9 V silkscreen
    - Rev B archived in archive/revB; fab outputs in fab/E0001_revB and fab/E0001_revC
    - Spec docs/SPEC_revC.md v1.0, schematic notes, layout review r1 (PASS)
    [E0001_fader_driver-B_Cu.gbl, E0001_fader_driver-B_Mask.gbs, E0001_fader_driver-B_Paste.gbp, E0001_fader_driver-B_Silkscreen.gbo, E0001_fader_driver-Edge_Cuts.gm1, E0001_fader_driver-F_Cu.gtl, E0001_fader_driver-F_Mask.gts, E0001_fader_driver-F_Paste.gtp]
2026-10-23 Rev C hand-route experiment: strip, scripted pre-route, Freerouting, cleanup
    All tracks and vias of the rev C board removed; placement, footprints,
    zones and net classes unchanged. Own scripts (build/hr, preroute_c.py)
    hand-route the motor loop, U3 supply, eFuse U4 PBUS_IN/VM_P power,
    the PBUS feed from J1, the touch nets, and a plane via for every
    GND/VM_P SMD pad. Freerouting 2.5.0 routes the rest; cleanup.py rebuilds
    the chains as 45-degree paths. Not TraceMaker. Some joins still to fix.
    [E0001_fader_driver.kicad_pcb, fr.dsn]
2026-10-23 Rev C hand-route: DRC clean, no acute or right-angle joins
    cleanup.py now recomputes chains after every rebuild (indices shifted).
    fixes_c.py: PBUS_IN/VM_P at the eFuse and C13 enter each pad at separate
    points, +3V3/LDO_IN/J1_SDA/I2C_SDA/FADER_POS/EF_OVLO joins redrawn at 45
    degrees, LDO_IN ends on the U2 tab's anchor.
    kicad-cli DRC with parity and refill: 0 errors, 0 unconnected, 0 parity;
    the one warning (J2 lib_footprint_mismatch) is the same on master 43d01a5.
    tm_viapad 0, slots 0, corners 0.
    [E0001_fader_driver.kicad_pcb]
